Peter-Wilson/MartiniBot/Pictures/going_forward.png

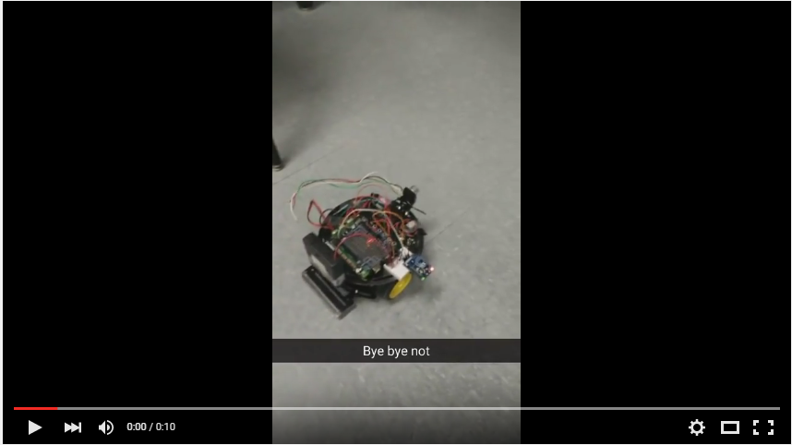
Pictures/going_forward.png
