Peter-Wilson/MartiniBot/Pictures/moving_directions.png

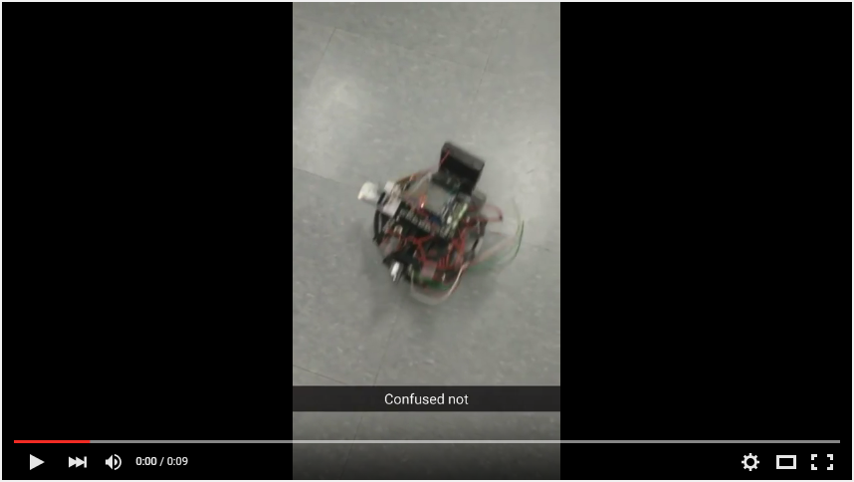
Pictures/moving_directions.png
