Peter-Wilson/MartiniBot/Pictures/sensing_diagram.png

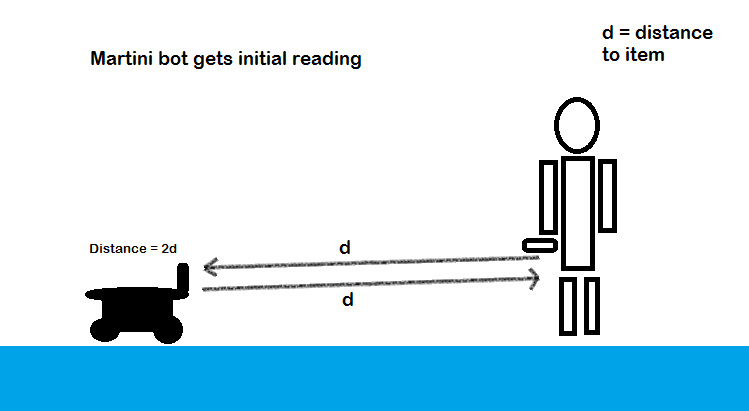
Pictures/sensing_diagram.png
