Peter-Wilson/MartiniBot/Pictures/sensing_diagram_2.png

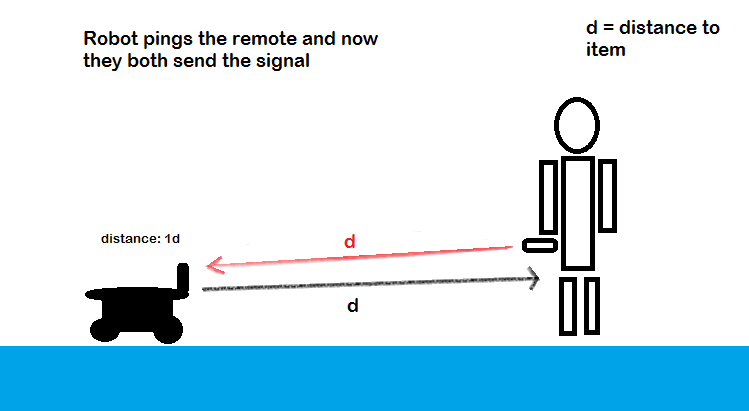
Pictures/sensing_diagram_2.png
