Peter-Wilson/MartiniBot/Pictures/sensing_diagram_3.png

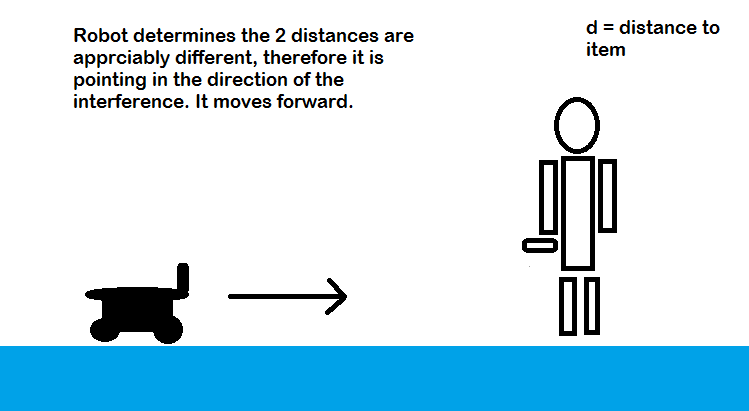
Pictures/sensing_diagram_3.png
