Peter-Wilson/MartiniBot/(commit log)

2016-04-13 added the ultrasonic api
2016-04-13 Update the ultrasonic sensor code
    This should allow for separate sending and recieving
2016-04-14 added motor controls
2016-04-15 Get the new ultrasonic library working with code
2016-04-17 Included encoder code to judge where the robot went
2016-04-20 added schematic for the hackduino/remote
